GennadyCC/z_home_RF_spectrum_analyzer/README.md

# z_home_RF_spectrum_analyzer
home project RF spectrum analyzer
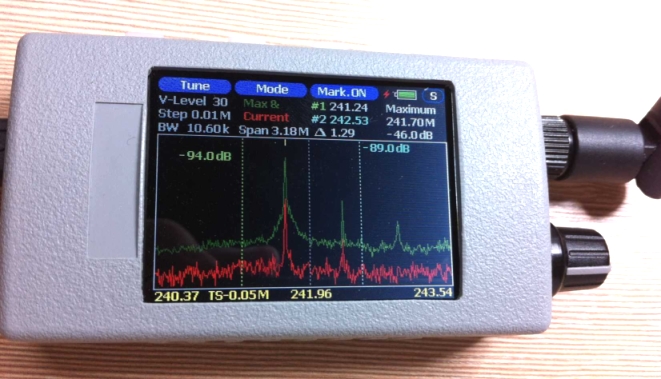
[picture p1: 2_pictures_video/6.jpg]

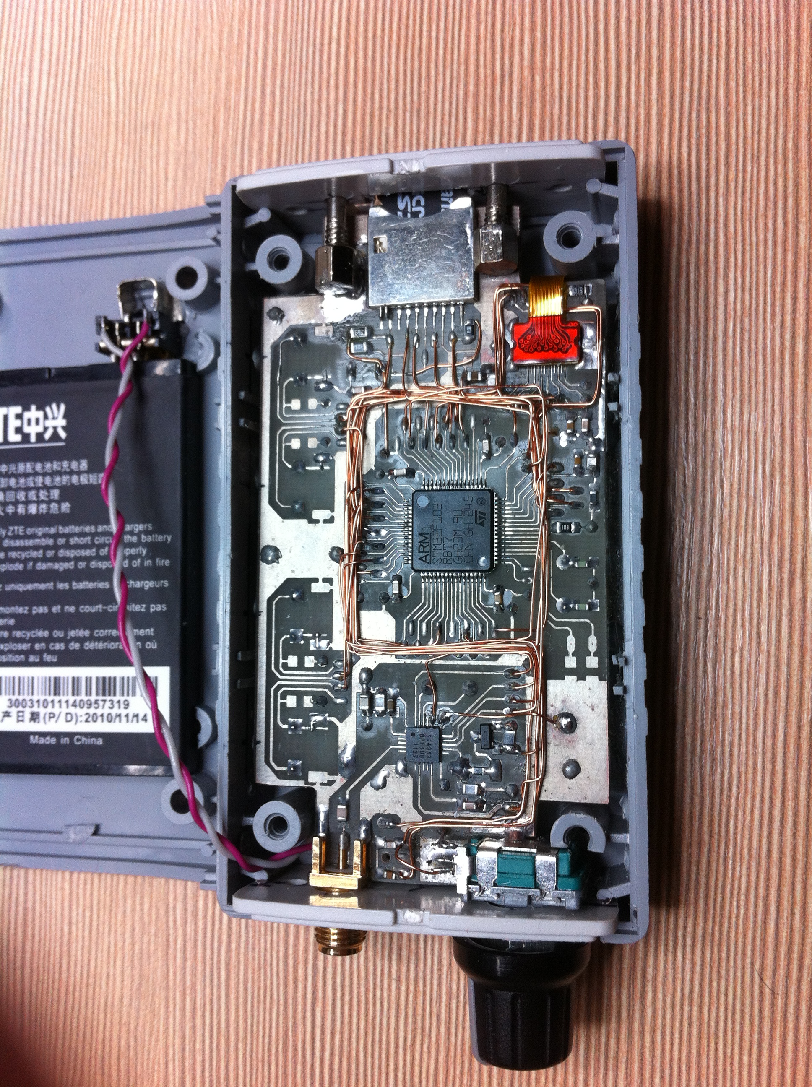
[picture p2: 2_pictures_video/3.JPG]
