GennadyCC/z_home_RF_spectrum_analyzer/1_schematic_lay/0_1_SA_si4313_v2_1.JPG

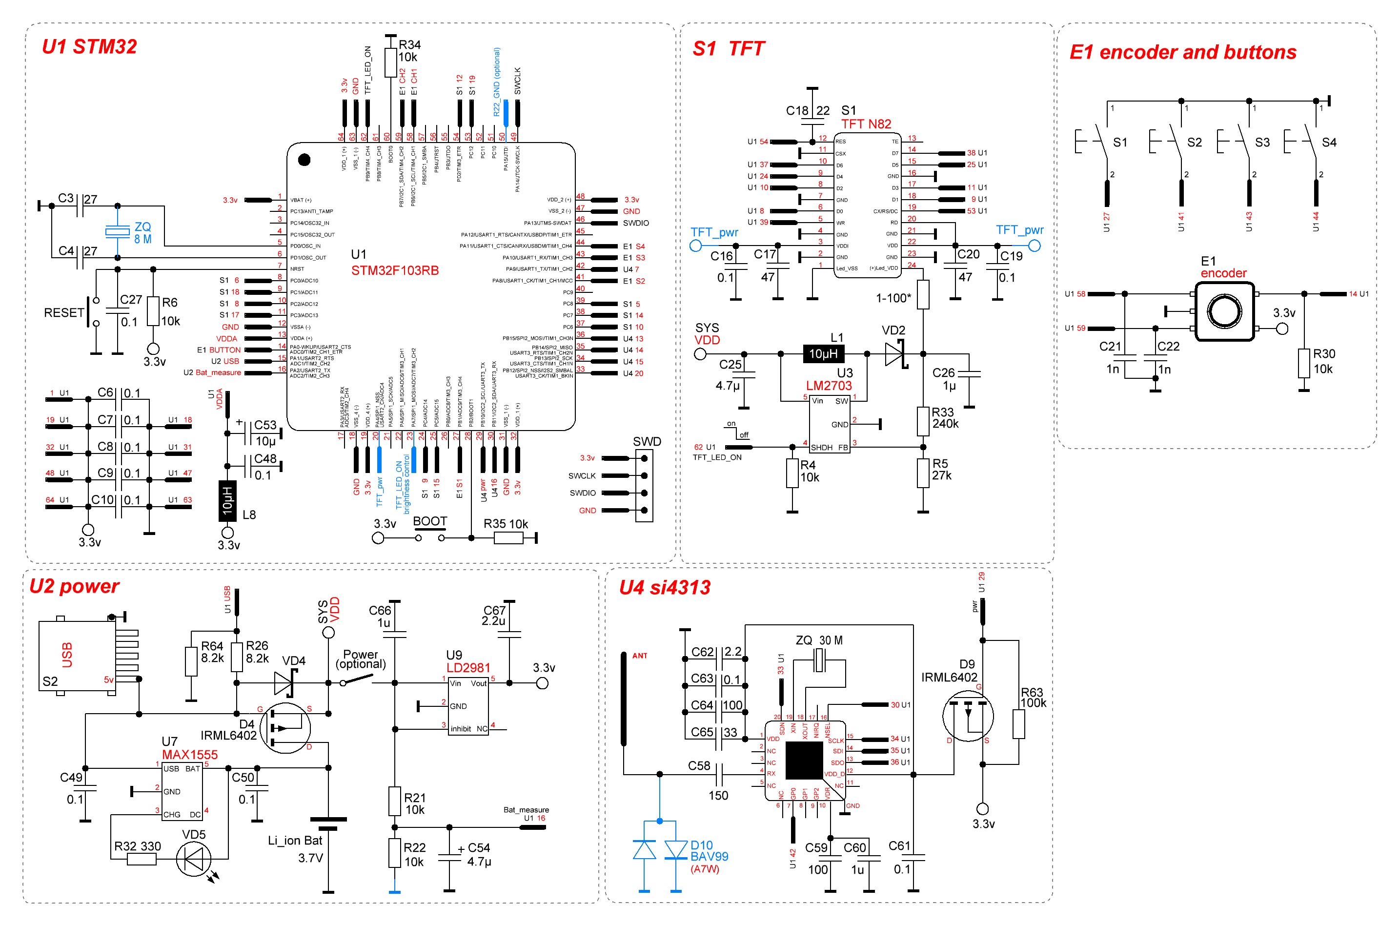
1_schematic_lay/0_1_SA_si4313_v2_1.JPG
