GennadyCC/z_home_RF_spectrum_analyzer/1_schematic_lay/1.png

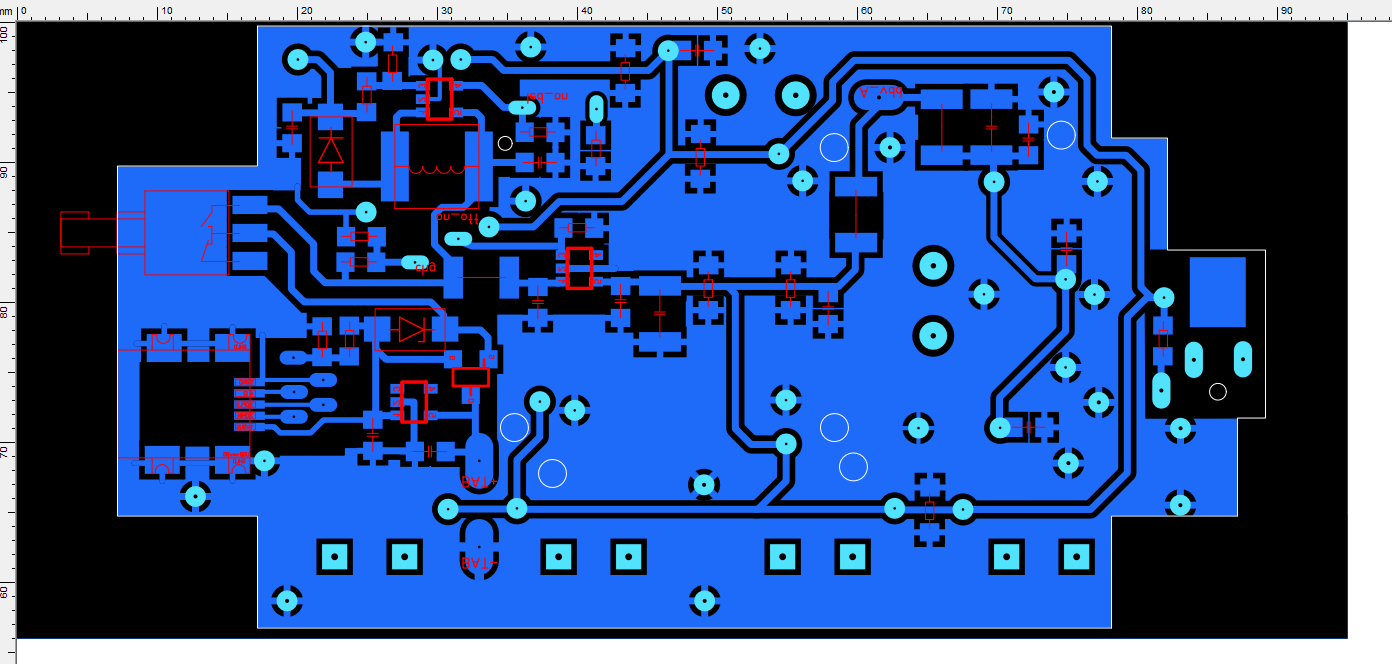
1_schematic_lay/1.png
