GennadyCC/z_home_RF_spectrum_analyzer/2_pictures_video/1.JPG

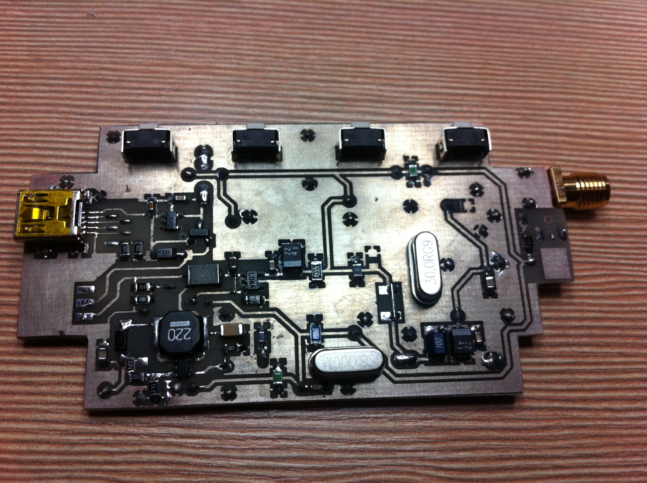
2_pictures_video/1.JPG
