GennadyCC/z_home_RF_spectrum_analyzer/2_pictures_video/5.jpg

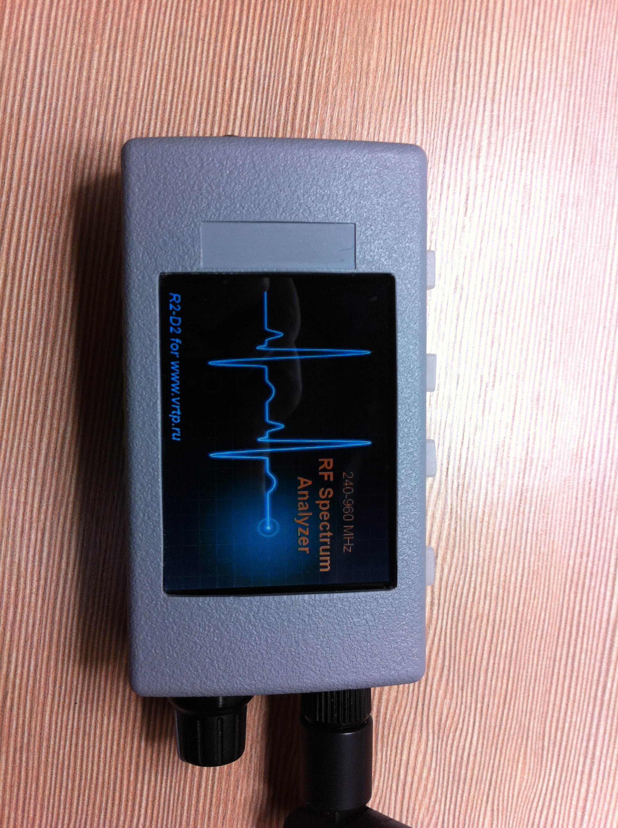
2_pictures_video/5.jpg
