GennadyCC/z_home_RF_spectrum_analyzer/1_schematic_lay/back.pdf

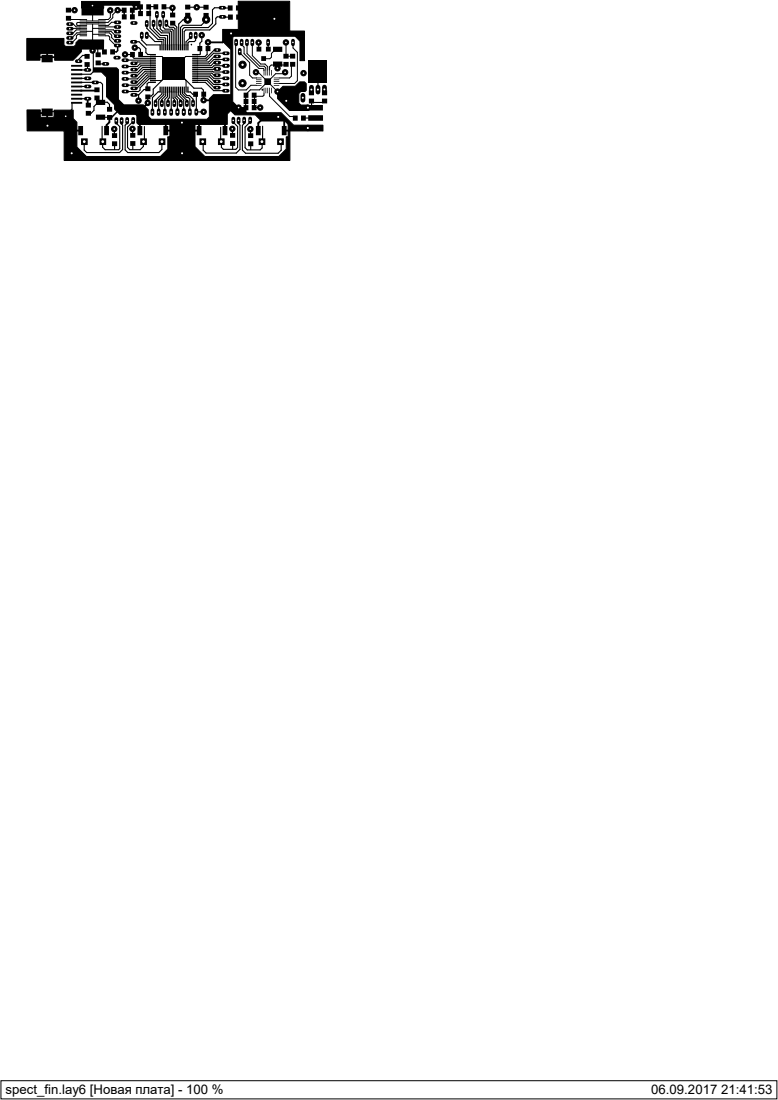
[picture p32: page 1]
spect_fin.lay6 [Новая плата] - 100 %
