GennadyCC/z_home_RF_spectrum_analyzer/1_schematic_lay/front.pdf

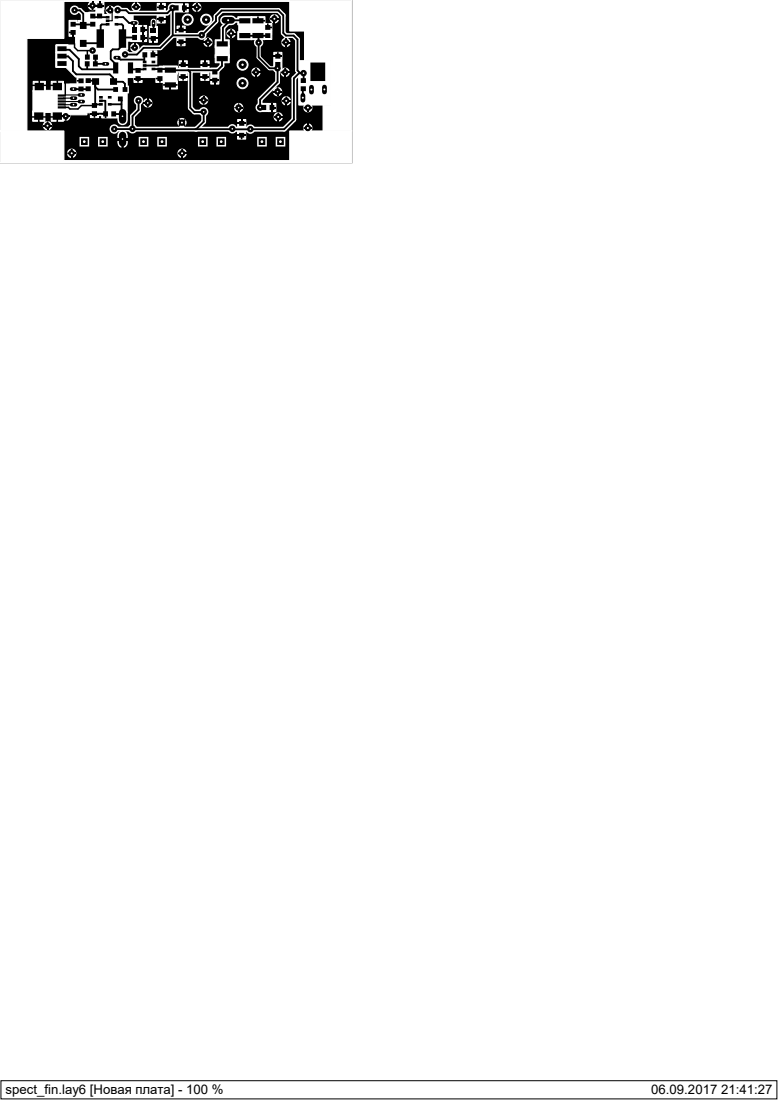
[picture p33: page 1]
spect_fin.lay6 [Новая плата] - 100 %
