GennadyCC/z_home_RF_spectrum_analyzer/(list of files, drawings)

Other design files:
1_schematic_lay/0_2_SA_si4313_v2_1.spl7
